Microsoluciones/MDL-AM/README.md

# MDL-AM
Mesita de Luz y Ajedrez Magico consisten en 2 elementos escenograficos.

En este repositorio se encuentran los programas desarrollados para la Mesita de Luz. Consiste en un telefono apoyado sobre la mesita de luz, el cajon de la mesita posee un electroiman controlado por el telefono. El telefono esta modificado electronicamente. El acertijo presente en el telefono, consiste en introducir un numero de telefono en el panel numerico, al ingresar el numero correcto, se debloquea el cajon.
