Microsoluciones/MDL-AM/Desarrollo/Recursos/Esquematico.pdf

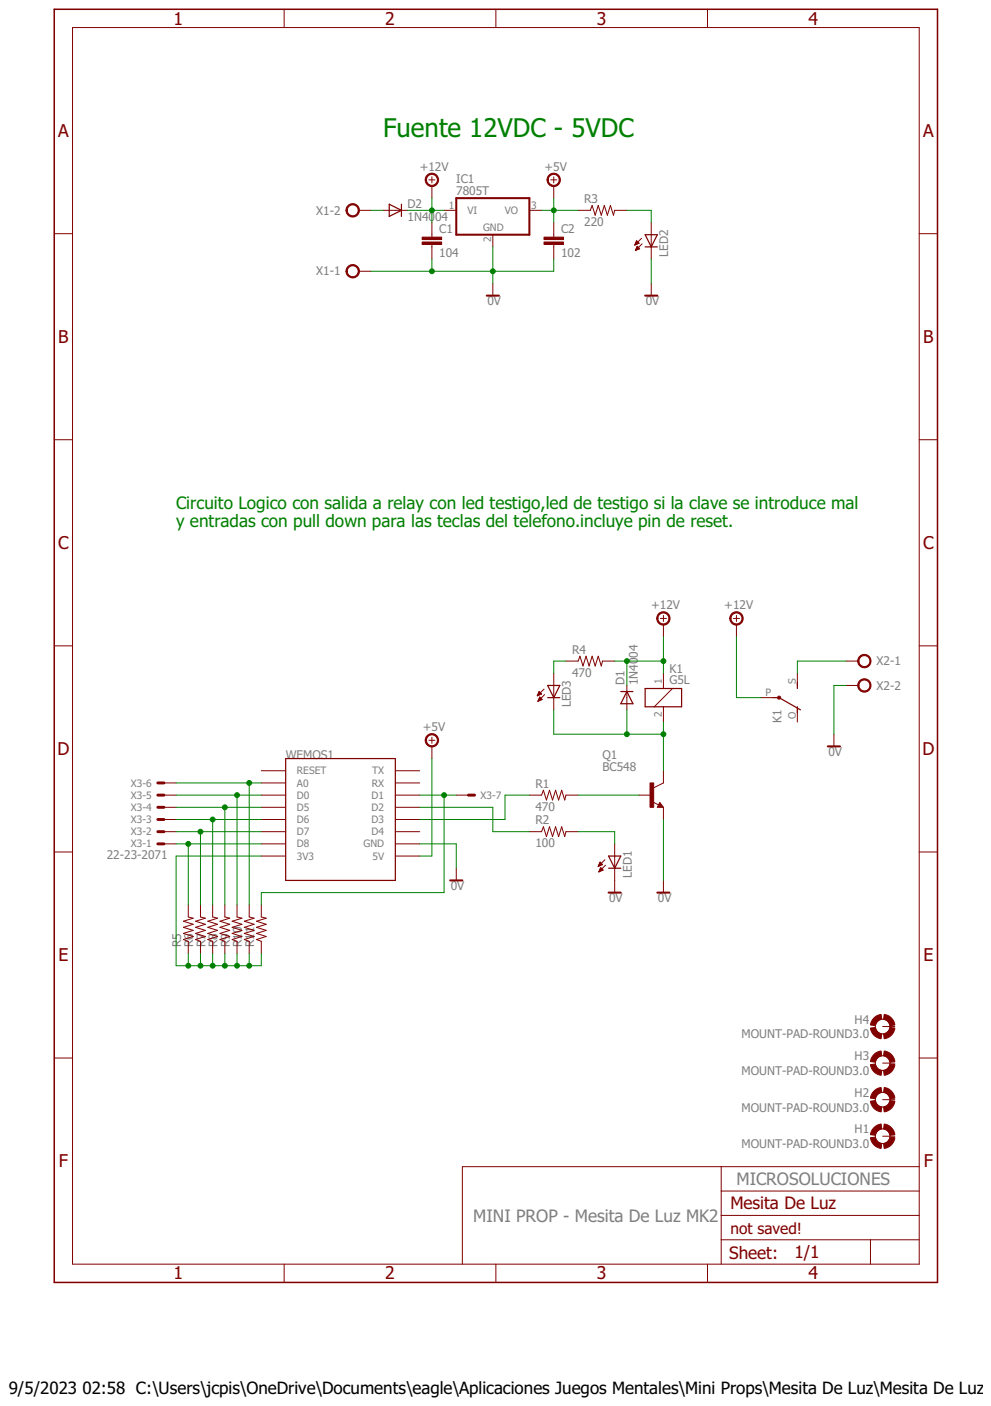
[picture p1: page 1]

Circuito Logico con salida a relay con led testigo,led de testigo si la clave se introduce mal
y entradas con pull down para las teclas del telefono.incluye pin de reset.

MINI PROP - Mesita De Luz MK2

9/5/2023 02:58 C:\Users\jcpis\OneDrive\Documents\eagle\Aplicaciones Juegos Mentales\Mini Props\Mesita De Luz\Mesita De Luz.sch (Sheet: 1/1)
