Microsoluciones/MDL-AM/(commit log)

2023-05-14 Agregados los archivos de proyecto.
2023-05-15 Pin Mode eliminados.
2023-05-28 Agregada ultima version de codigo presente en el prop. ESTADO: Funcionando.
2023-05-28 agregado informe de desarrollo tecnico
